bge007/ep4ce6e22-enc28j60-ethernet/docs/OLED-SSD1306-3.jpg

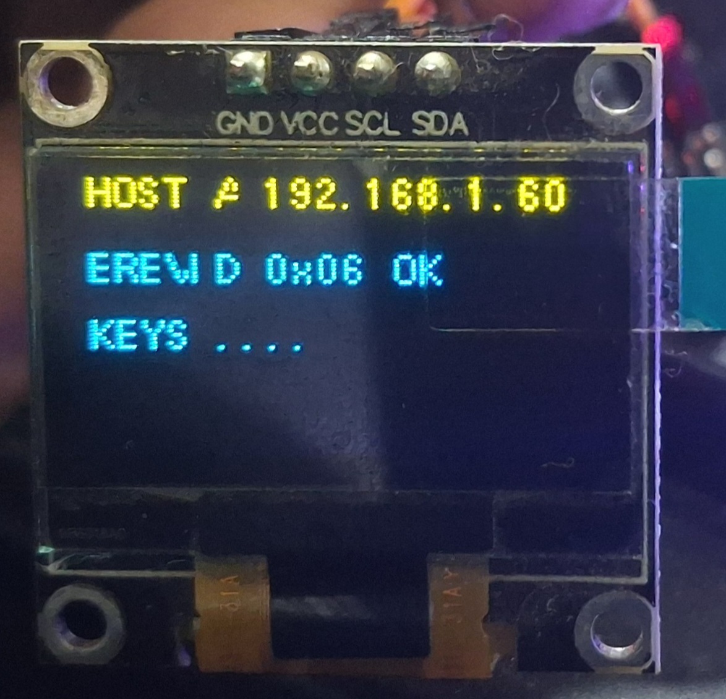
docs/OLED-SSD1306-3.jpg
