bge007/ep4ce6e22-enc28j60-ethernet/rtl/oled_ssd1306.v

// oled_ssd1306.v -- 1.3" 128x64 OLED (QG-2864KSWLG01) over I2C.
//
// Text-only: a 4 x 21 character buffer is rendered to display pages 0, 2, 4
// and 6, leaving the odd pages blank so the lines have air between them.
// Glyphs are 5x8 with a one-column gap, so 21 characters span 126 of 128
// columns.
//
// CONTROLLER IDENTIFICATION
// --------------------------
// The panel's own datasheet is internally inconsistent -- the mechanical
// drawing and section 4.1 both say "SH1106G", but the page-15 reference
// schematic is labelled "SSD1306 / 0.96''". An SH1106 init sequence was
// tried first on that basis and got the panel talking over I2C (clean ACKs)
// but intermittently blank; confirmed on the real module that the silicon is
// actually SSD1306 -- no +2 RAM column offset, and the SSD1306 charge-pump
// command (0x8D 0x14) rather than SH1106's (0xAD 0x8B + VPP 0x32).
//
// Both memories are read synchronously so they infer M9K blocks. Cyclone IV E
// has no LUT RAM, so an asynchronous read would become flip-flops plus a wide
// mux -- around 700 LEs for the character buffer alone. The FSM stalls on the
// I2C master for tens of microseconds per byte, so a cycle of read latency is
// free.

module oled_ssd1306 #(
    parameter integer CLK_HZ    = 50_000_000,
    parameter [6:0]   I2C_ADR   = 7'h3C,           // 0111100b; 0x3D if D/C# high
    // Wait before touching the panel at all. Was 100 ms, raised to 500 ms
    // after a cold-boot failure on real hardware (2026-08-27): on a power-up
    // the panel's own POR runs at the same time as the FPGA's, and at 100 ms
    // it is not yet ready -- it ACKs the init bytes on I2C but ignores them,
    // leaving the display dark. Pressing RESET much later always worked
    // because by then the panel had long since settled. A JTAG reconfigure
    // never showed the fault either, for the same reason.
    parameter integer POR_TICKS    = 25_000_000,   // 500 ms at 50 MHz
    // ...and then do the whole init a second time, once, a second after boot.
    // A fixed delay alone is a tuned guess about someone else's RC circuit;
    // the retry makes a cold boot succeed even if the first attempt was still
    // too early. Harmless when the first attempt already worked -- it just
    // re-initialises and repaints.
    parameter integer REINIT_TICKS = 50_000_000    // 1 s at 50 MHz
) (
    input  wire       clk,
    input  wire       rst,

    // Character buffer write port. addr = line*21 + column.
    input  wire       txt_we,
    input  wire [6:0] txt_addr,
    input  wire [7:0] txt_char,

    input  wire       refresh,                     // pulse: redraw the panel
    output reg        ready,                       // idle and safe to refresh
    output wire       i2c_err,                     // display did not ACK

    inout  wire       oled_scl,
    inout  wire       oled_sda
);

    localparam integer COLS   = 21;
    localparam [7:0]   ADDR_W = {I2C_ADR, 1'b0};   // write address byte, 0x78

    // ------------------------------------------------------------------
    // I2C master
    // ------------------------------------------------------------------
    reg        c_start, c_write, c_stop;
    reg  [7:0] c_data;
    wire       i2c_busy, i2c_ack_err;

    i2c_master #(.CLK_HZ(CLK_HZ), .I2C_HZ(400_000)) u_i2c (
        .clk(clk), .rst(rst),
        .cmd_start(c_start), .cmd_write(c_write), .cmd_stop(c_stop),
        .wr_data(c_data), .busy(i2c_busy), .ack_err(i2c_ack_err),
        .scl(oled_scl), .sda(oled_sda)
    );

    assign i2c_err = i2c_ack_err;

    // ------------------------------------------------------------------
    // Init sequence, standard SSD1306 datasheet order.
    // ------------------------------------------------------------------
    localparam integer INIT_N = 24;
    reg [7:0] initrom [0:INIT_N-1];
    initial begin
        initrom[ 0] = 8'hAE;                        // display off
        initrom[ 1] = 8'h00;                        // lower column = 0
        initrom[ 2] = 8'h10;                        // higher column = 0
        initrom[ 3] = 8'h40;                        // start line 0
        initrom[ 4] = 8'hB0;                        // page 0
        initrom[ 5] = 8'h81; initrom[ 6] = 8'hBF;   // contrast
        initrom[ 7] = 8'hA1;                        // segment remap
        initrom[ 8] = 8'hA6;                        // normal, not inverted
        initrom[ 9] = 8'hA8; initrom[10] = 8'h3F;   // multiplex 1/64
        initrom[11] = 8'h8D; initrom[12] = 8'h14;   // charge pump enable
        initrom[13] = 8'hC8;                        // COM scan remapped
        initrom[14] = 8'hD3; initrom[15] = 8'h00;   // display offset 0
        initrom[16] = 8'hD5; initrom[17] = 8'h80;   // clock divide / osc
        initrom[18] = 8'hD9; initrom[19] = 8'h22;   // pre-charge
        initrom[20] = 8'hDA; initrom[21] = 8'h12;   // COM pins
        initrom[22] = 8'hDB; initrom[23] = 8'h40;   // VCOMH
    end

    localparam [7:0] CTL_CMD  = 8'h00;   // Co=0, D/C=0 -> command stream
    localparam [7:0] CTL_DATA = 8'h40;   // Co=0, D/C=1 -> data stream

    // ------------------------------------------------------------------
    // Column walk. Kept as counters rather than col/6 and col%6, which would
    // otherwise infer constant dividers.
    // ------------------------------------------------------------------
    reg [7:0] col;        // 0..128, where 128 means "page finished"
    reg [2:0] gcol;       // 0..5 within the character cell
    reg [4:0] cidx;       // 0..20 character index in the line
    reg [2:0] page;       // 0..7

    wire       is_text_page = ~page[0];
    wire [1:0] text_line    = page[2:1];

    // ------------------------------------------------------------------
    // Character buffer and font, both synchronous-read (M9K)
    // ------------------------------------------------------------------
    reg [7:0] textbuf [0:COLS*4-1];
    reg [7:0] tb_q;
    wire [6:0] tb_addr = text_line * COLS + cidx;

    // Start blank rather than relying on M9K powering up to zero. Quartus
    // turns this into the RAM's initial contents; without it the unwritten
    // cells read as X in simulation.
    integer k;
    initial for (k = 0; k < COLS*4; k = k + 1) textbuf[k] = 8'h20;   // space

    always @(posedge clk) begin
        if (txt_we) textbuf[txt_addr] <= txt_char;
        tb_q <= textbuf[tb_addr];
    end

    reg [7:0] font [0:474];
    reg [7:0] font_q;
    initial $readmemh("font5x8.mem", font);

    wire        ch_ok   = (tb_q >= 8'd32) && (tb_q <= 8'd126);
    wire [8:0]  ch_off  = ch_ok ? (tb_q - 8'd32) : 9'd0;
    wire [11:0] f_addr  = ch_off * 5 + gcol;

    always @(posedge clk) font_q <= font[f_addr[8:0]];

    // A byte is blank on odd pages, past the end of the line, in the
    // inter-character gap, or for an unprintable code.
    wire blank = !is_text_page || (cidx >= COLS) || (gcol == 3'd5) || !ch_ok;

    // ------------------------------------------------------------------
    // FSM
    // ------------------------------------------------------------------
    localparam S_POR      = 4'd0,
               S_I_START  = 4'd1,
               S_I_ADDR   = 4'd2,
               S_I_CTL    = 4'd3,
               S_I_BYTE   = 4'd4,
               S_I_STOP   = 4'd5,
               S_AFTER_I  = 4'd6,
               S_IDLE     = 4'd7,
               S_P_START  = 4'd8,
               S_P_ADDR   = 4'd9,
               S_P_CTL    = 4'd10,
               S_P_CMD    = 4'd11,
               S_P_DSTART = 4'd12,
               S_P_DADDR  = 4'd13,
               S_P_DCTL   = 4'd14,
               S_P_DATA   = 4'd15;

    reg [3:0]  st;
    reg [26:0] delay;
    reg [4:0]  init_i;
    reg [1:0]  cmd_i;
    reg        turn_on;      // this init pass sends 0xAF rather than the table
    reg        clear_pass;   // paint blanks, not text
    reg        reinit_pending;  // one-shot cold-boot re-init, see REINIT_TICKS
    reg        reinit_repaint;  // after that re-init, repaint text (not just clear)
    reg [26:0] life_cnt;        // cycles since reset, saturating at REINIT_TICKS

    localparam [7:0] LOWER_COL = 8'h00;   // SSD1306: no RAM offset

    wire [7:0] page_cmd = (cmd_i == 2'd0) ? (8'hB0 | {5'd0, page}) :
                          (cmd_i == 2'd1) ? LOWER_COL :
                                            8'h10;      // higher col = 0

    task reset_walk;
        begin
            page  <= 3'd0;
            col   <= 8'd0;
            gcol  <= 3'd0;
            cidx  <= 5'd0;
            cmd_i <= 2'd0;
        end
    endtask

    always @(posedge clk) begin
        c_start <= 1'b0;
        c_write <= 1'b0;
        c_stop  <= 1'b0;

        if (rst) begin
            st         <= S_POR;
            delay      <= 0;
            init_i     <= 5'd0;
            ready      <= 1'b0;
            turn_on    <= 1'b0;
            clear_pass <= 1'b1;
            reinit_pending <= 1'b1;
            reinit_repaint <= 1'b0;
            life_cnt       <= 27'd0;
            reset_walk;
        end else begin
            if (life_cnt != REINIT_TICKS[26:0]) life_cnt <= life_cnt + 27'd1;
            case (st)
                S_POR:
                    if (delay == POR_TICKS) begin
                        delay <= 0;
                        st    <= S_I_START;
                    end else delay <= delay + 1'b1;

                S_I_START:
                    if (!i2c_busy) begin c_start <= 1'b1; st <= S_I_ADDR; end

                S_I_ADDR:
                    if (!i2c_busy && !c_start) begin
                        c_data <= ADDR_W; c_write <= 1'b1; st <= S_I_CTL;
                    end

                S_I_CTL:
                    if (!i2c_busy && !c_write) begin
                        c_data <= CTL_CMD; c_write <= 1'b1; st <= S_I_BYTE;
                    end

                S_I_BYTE:
                    if (!i2c_busy && !c_write) begin
                        if (turn_on) begin
                            c_data  <= 8'hAF;               // display on
                            c_write <= 1'b1;
                            st      <= S_I_STOP;
                        end else if (init_i == INIT_N) begin
                            st <= S_I_STOP;
                        end else begin
                            c_data  <= initrom[init_i];
                            c_write <= 1'b1;
                            init_i  <= init_i + 5'd1;
                        end
                    end

                S_I_STOP:
                    if (!i2c_busy && !c_write) begin c_stop <= 1'b1; st <= S_AFTER_I; end

                // Datasheet order: initialise, clear the RAM, then switch the
                // panel on -- so power-up noise is never displayed.
                S_AFTER_I:
                    if (!i2c_busy && !c_stop) begin
                        if (turn_on) begin
                            // Display-on has just been sent. On the normal
                            // boot path the caller repaints on its next
                            // change, so idling here is fine. After a
                            // re-init it is NOT: the clear pass just blanked
                            // the panel, and eth_top only issues a refresh
                            // when something changes -- so nothing would ever
                            // repaint and the display would sit blank. (That
                            // is exactly what happened on hardware: text for
                            // ~1 s, then the re-init blanked it for good.)
                            // textbuf still holds the text, so paint it back.
                            if (reinit_repaint) begin
                                reinit_repaint <= 1'b0;
                                reset_walk;
                                st <= S_P_START;   // clear_pass is 0 -> paints text
                            end else begin
                                ready <= 1'b1;
                                st    <= S_IDLE;
                            end
                        end else begin
                            reset_walk;
                            st <= S_P_START;
                        end
                    end

                S_IDLE:
                    if (refresh && !i2c_busy) begin
                        ready <= 1'b0;
                        reset_walk;
                        st <= S_P_START;
                    end else if (reinit_pending && !i2c_busy &&
                                 life_cnt == REINIT_TICKS[26:0]) begin
                        // Cold-boot safety net: redo init -> clear -> display-on
                        // once, now that the panel has certainly settled.
                        reinit_pending <= 1'b0;
                        reinit_repaint <= 1'b1;
                        init_i         <= 5'd0;
                        turn_on        <= 1'b0;
                        clear_pass     <= 1'b1;
                        ready          <= 1'b0;
                        reset_walk;
                        st             <= S_I_START;
                    end

                S_P_START:
                    if (!i2c_busy) begin c_start <= 1'b1; st <= S_P_ADDR; end

                S_P_ADDR:
                    if (!i2c_busy && !c_start) begin
                        c_data <= ADDR_W; c_write <= 1'b1; st <= S_P_CTL;
                    end

                S_P_CTL:
                    if (!i2c_busy && !c_write) begin
                        c_data <= CTL_CMD; c_write <= 1'b1; st <= S_P_CMD;
                    end

                S_P_CMD:
                    if (!i2c_busy && !c_write) begin
                        c_data  <= page_cmd;
                        c_write <= 1'b1;
                        if (cmd_i == 2'd2) begin cmd_i <= 2'd0; st <= S_P_DSTART; end
                        else                      cmd_i <= cmd_i + 2'd1;
                    end

                // Repeated START to switch from the command to the data stream.
                S_P_DSTART:
                    if (!i2c_busy && !c_write) begin c_start <= 1'b1; st <= S_P_DADDR; end

                S_P_DADDR:
                    if (!i2c_busy && !c_start) begin
                        c_data <= ADDR_W; c_write <= 1'b1; st <= S_P_DCTL;
                    end

                S_P_DCTL:
                    if (!i2c_busy && !c_write) begin
                        c_data <= CTL_DATA; c_write <= 1'b1; st <= S_P_DATA;
                    end

                S_P_DATA:
                    if (!i2c_busy && !c_write) begin
                        if (col == 8'd128) begin
                            c_stop <= 1'b1;
                            col    <= 8'd0;
                            gcol   <= 3'd0;
                            cidx   <= 5'd0;
                            if (page == 3'd7) begin
                                page <= 3'd0;
                                if (clear_pass) begin
                                    clear_pass <= 1'b0;
                                    turn_on    <= 1'b1;
                                    st         <= S_I_START;   // now send 0xAF
                                end else begin
                                    ready <= 1'b1;
                                    st    <= S_IDLE;
                                end
                            end else begin
                                page <= page + 3'd1;
                                st   <= S_P_START;
                            end
                        end else begin
                            c_data  <= (clear_pass || blank) ? 8'h00 : font_q;
                            c_write <= 1'b1;
                            col     <= col + 8'd1;
                            if (gcol == 3'd5) begin
                                gcol <= 3'd0;
                                cidx <= cidx + 5'd1;
                            end else begin
                                gcol <= gcol + 3'd1;
                            end
                        end
                    end

                default: st <= S_POR;
            endcase
        end
    end

endmodule
