bge007/ep4ce6e22-enc28j60-ethernet/tb/tb_uart.v

// tb_uart.v -- self-checking testbench for the serial console.
//
// What it proves:
//   * uart_tx -> uart_rx round-trips arbitrary bytes at the real bit rate
//   * the banner is transmitted at reset, with the host letter substituted
//   * pressing a button emits "KEYS 0..." with a character per key
//   * a line typed into uart_rx lands in the message buffer and is echoed
//     back as "MSG: ..."
//   * backspace erases, and over-long input is truncated rather than wrapping
//
// Run:  vlog -sv ../rtl/uart_tx.v ../rtl/uart_rx.v ../rtl/uart_console.v ../tb/tb_uart.v
//       vsim -c -do "run -all; quit -f" tb_uart

`timescale 1ns/1ps

module tb_uart;

    localparam integer CLK_HZ = 50_000_000;
    localparam integer BAUD   = 115200;
    localparam real    BIT_NS = 1_000_000_000.0 / BAUD;

    reg clk = 0;
    always #10 clk = ~clk;                 // 50 MHz
    reg rst = 1;

    // ------------------------------------------------------------------
    // Part 1: raw PHY loopback
    // ------------------------------------------------------------------
    reg  [7:0] p_tx_data;
    reg        p_tx_valid;
    wire       p_tx_ready, p_line;
    wire [7:0] p_rx_data;
    wire       p_rx_valid, p_rx_err;

    uart_tx #(.CLK_HZ(CLK_HZ), .BAUD(BAUD)) u_ptx (
        .clk(clk), .rst(rst), .tx_data(p_tx_data), .tx_valid(p_tx_valid),
        .tx_ready(p_tx_ready), .tx(p_line));

    uart_rx #(.CLK_HZ(CLK_HZ), .BAUD(BAUD)) u_prx (
        .clk(clk), .rst(rst), .rx(p_line),
        .rx_data(p_rx_data), .rx_valid(p_rx_valid), .rx_err(p_rx_err));

    reg [7:0] got_byte;
    reg       got_flag;
    always @(posedge clk) if (p_rx_valid) begin got_byte <= p_rx_data; got_flag <= 1'b1; end

    // ------------------------------------------------------------------
    // Part 2: the console
    // ------------------------------------------------------------------
    reg  [3:0] keys = 4'b0000;
    reg        keys_changed = 0;
    reg  [4:0] msg_addr = 0;
    wire [7:0] msg_char;
    wire       msg_updated;
    reg        host_rx = 1'b1;             // idle high, driven by the "PC"
    wire       host_tx;                    // console -> PC

    // Tied off: this testbench covers the UART/console path, not the OLED
    // status lines (tb_oled.v exercises the OLED driver itself). Holding
    // both low keeps req_oled_rdy/req_oled_err from ever firing here, so the
    // existing banner/keys/echo byte-stream assertions below stay exact.
    reg        oled_ready_tb = 1'b0;
    reg        oled_nack_tb  = 1'b0;
    reg        eth_ready_tb  = 1'b0;
    reg  [7:0] eth_econ1_tb  = 8'h00;
    // Both held at zero, matching oled_ready_tb/oled_nack_tb above: never
    // changing keeps req_net from ever firing here too.
    reg [15:0] net_frames_tb  = 16'd0;
    reg [15:0] net_replies_tb = 16'd0;
    reg [7:0]  net_eir_tb     = 8'd0;
    reg [7:0]  net_estat_tb   = 8'd0;
    reg [15:0] net_arpreqs_tb = 16'd0;
    reg [15:0] net_etype_tb   = 16'd0;
    reg [15:0] net_resyncs_tb  = 16'd0;
    reg [15:0] net_tsvcount_tb = 16'd0;
    reg [15:0] net_tsvwire_tb  = 16'd0;
    reg [7:0]  net_tsvs2_tb     = 8'd0;
    reg [7:0]  net_tsvs3_tb     = 8'd0;

    uart_console #(.CLK_HZ(CLK_HZ), .BAUD(BAUD), .HOST_ID(8'd1)) dut (
        .clk(clk), .rst(rst),
        .keys(keys), .keys_changed(keys_changed),
        .msg_rd_addr(msg_addr), .msg_rd_data(msg_char), .msg_updated(msg_updated),
        .oled_ready(oled_ready_tb), .oled_nack(oled_nack_tb),
        .eth_ready(eth_ready_tb), .eth_econ1(eth_econ1_tb),
        .net_frames(net_frames_tb), .net_replies(net_replies_tb),
        .net_eir(net_eir_tb), .net_estat(net_estat_tb),
        .net_arpreqs(net_arpreqs_tb), .net_etype(net_etype_tb),
        .net_resyncs(net_resyncs_tb),
        .net_tsvcount(net_tsvcount_tb), .net_tsvwire(net_tsvwire_tb),
        .net_tsvs2(net_tsvs2_tb), .net_tsvs3(net_tsvs3_tb),
        .uart_rx_pin(host_rx), .uart_tx_pin(host_tx));

    // Collect everything the console transmits.
    wire [7:0] c_rx_data;
    wire       c_rx_valid, c_rx_err;
    uart_rx #(.CLK_HZ(CLK_HZ), .BAUD(BAUD)) u_mon (
        .clk(clk), .rst(rst), .rx(host_tx),
        .rx_data(c_rx_data), .rx_valid(c_rx_valid), .rx_err(c_rx_err));

    reg [7:0] seen [0:255];
    integer   seen_n = 0;
    always @(posedge clk) if (c_rx_valid) begin seen[seen_n] = c_rx_data; seen_n = seen_n + 1; end

    integer errors = 0;
    integer i;

    // A string literal cannot be bit-sliced in place, so park it in a reg.
    reg [8*11-1:0] hello = "Hello World";

    // Drive one byte into the console's RX pin at the real bit rate.
    task pc_send(input [7:0] b);
        integer n;
        begin
            host_rx = 1'b0;                       // start
            #(BIT_NS);
            for (n = 0; n < 8; n = n + 1) begin
                host_rx = b[n];                   // LSB first
                #(BIT_NS);
            end
            host_rx = 1'b1;                       // stop
            #(BIT_NS);
            #(BIT_NS/2);                          // a little idle between bytes
        end
    endtask

    task pc_send_str(input [8*24-1:0] s, input integer len);
        integer n;
        begin
            for (n = len - 1; n >= 0; n = n - 1)
                pc_send(s[8*n +: 8]);
        end
    endtask

    // Does the collected stream contain this string?
    function integer contains(input [8*32-1:0] pat, input integer len);
        integer a, b_, ok;
        begin
            contains = -1;
            for (a = 0; a <= seen_n - len; a = a + 1) begin
                ok = 1;
                for (b_ = 0; b_ < len; b_ = b_ + 1)
                    if (seen[a+b_] !== pat[8*(len-1-b_) +: 8]) ok = 0;
                if (ok && contains < 0) contains = a;
            end
        end
    endfunction

    task check(input cond, input [40*8:0] what);
        begin
            if (!cond) begin $display("FAIL: %0s", what); errors = errors + 1; end
        end
    endtask

    initial begin
        got_flag = 0;
        #200 rst = 0;

        // ---------------- PHY loopback ----------------
        @(posedge clk);
        wait (p_tx_ready);
        p_tx_data = 8'hA5; p_tx_valid = 1; @(posedge clk); p_tx_valid = 0;
        wait (got_flag);
        check(got_byte === 8'hA5, "loopback byte 0xA5 corrupted");
        check(p_rx_err === 1'b0,  "loopback framing error");
        got_flag = 0;

        wait (p_tx_ready);
        p_tx_data = 8'h3C; p_tx_valid = 1; @(posedge clk); p_tx_valid = 0;
        wait (got_flag);
        check(got_byte === 8'h3C, "loopback byte 0x3C corrupted");
        $display("INFO: PHY loopback OK");

        // ---------------- banner ----------------
        #(BIT_NS * 12 * 26);
        check(contains("EP4CE6E22 node A ready", 22) >= 0,
              "banner not transmitted, or host letter wrong");
        $display("INFO: banner seen, %0d bytes so far", seen_n);

        // ---------------- identity line ----------------
        // Emitted once at power-up and then every ~2.7 s, so a build tool can
        // work out which board is on the other end of a console cable by
        // listening alone -- no reset (which would throw away the run's state)
        // and no keystroke (which would collide with the typed-message path).
        // The ID line is 52 characters now that it carries the MAC readback;
        // this window has to clear the whole line or the checks that follow
        // start reading mid-sentence.
        #(BIT_NS * 12 * 56);
        check(contains("ID HOST=A BLD=", 14) >= 0,
              "identity line missing or malformed");
        $display("INFO: ID line seen");
        seen_n = 0;

        // ---------------- button press ----------------
        seen_n = 0;
        @(posedge clk); keys = 4'b0001; keys_changed = 1; @(posedge clk); keys_changed = 0;
        #(BIT_NS * 12 * 13);
        check(contains("KEYS 0...", 9) >= 0, "KEYS line wrong for key0 pressed");

        seen_n = 0;
        @(posedge clk); keys = 4'b1010; keys_changed = 1; @(posedge clk); keys_changed = 0;
        #(BIT_NS * 12 * 13);
        check(contains("KEYS .1.3", 9) >= 0, "KEYS line wrong for keys 1 and 3 pressed");
        $display("INFO: button lines OK");

        // ---------------- receive a line ----------------
        seen_n = 0;
        pc_send_str(hello, 11);
        pc_send(8'h0D);                            // CR terminates
        #(BIT_NS * 12 * 32);

        check(msg_updated === 1'b0, "msg_updated should be a 1-cycle pulse, not level");
        for (i = 0; i < 11; i = i + 1) begin
            msg_addr = i[4:0];
            @(posedge clk); @(posedge clk);
            if (msg_char !== hello[8*(10-i) +: 8]) begin
                $display("FAIL: msg[%0d] = 0x%02h ('%0s'), expected '%0s'",
                         i, msg_char, msg_char, hello[8*(10-i) +: 8]);
                errors = errors + 1;
            end
        end
        // the tail must be blank, not leftovers
        msg_addr = 5'd15; @(posedge clk); @(posedge clk);
        check(msg_char === 8'h20, "message tail not blank-padded");
        check(contains("MSG: Hello World", 16) >= 0, "line not echoed back as MSG:");
        $display("INFO: line receive + echo OK");

        // ---------------- backspace ----------------
        seen_n = 0;
        pc_send_str("abX", 3);
        pc_send(8'h08);                            // backspace kills the X
        pc_send(8'h0A);                            // LF also terminates
        #(BIT_NS * 12 * 32);
        msg_addr = 5'd0; @(posedge clk); @(posedge clk);
        check(msg_char === "a", "backspace test: msg[0] wrong");
        msg_addr = 5'd1; @(posedge clk); @(posedge clk);
        check(msg_char === "b", "backspace test: msg[1] wrong");
        msg_addr = 5'd2; @(posedge clk); @(posedge clk);
        check(msg_char === 8'h20, "backspace did not erase the character");
        $display("INFO: backspace OK");

        if (errors == 0)
            $display("PASS: UART loopback, banner, ID line, key lines, line receive, echo, backspace");
        else
            $display("%0d ERROR(S)", errors);
        $finish;
    end

    initial begin
        #500_000_000;
        $display("FAIL: timeout");
        $finish;
    end

endmodule
