bge007/ep4ce6e22-enc28j60-ethernet/(commit log)

2026-08-22 M1: SPI master and ENC28J60 EREVID readback
    First milestone of a hardware ARP/ICMP/UDP stack for the EP4CE6E22 driving
    an ENC28J60 over SPI. Proves the full SPI path end to end: reset sequencing,
    soft reset opcode, bank select, and an EREVID read displayed on the LEDs.
    - spi_master.v: byte-streaming SPI mode 0, burst-capable, parameterised divider
    - eth_top.v: reset/init FSM, EREVID read at 12.5 MHz, LED display with a
    button-held alternate view for diagnosing stuck MISO
    - tb_m1.v: self-checking testbench against a behavioral ENC28J60 slave model
    - docs: design rationale and throughput budget, two-node wiring including the
    crossover requirement, and LED-by-LED bring-up guidance
    Simulat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
    [eth_top.v, spi_master.v, tb_m1.v]
2026-08-22 Move the SPI bus onto the fixed-3.3V header (bank 6)
    Board photographs resolved the header layout that was previously guessed, and
    the old assignment turned out to be unsafe.
    PIN_110/111 sit on the top header, the C group, whose bank voltage is chosen
    with a jumper cap and which the fitter reports as bank 7. The ENC28J60 drives
    SO and INT at 3.3 V, so an FPGA input there with VC jumpered to 1.2 or 2.5 V
    is over-driven. All six signals now sit on the right-hand header, which the
    board documents as a fixed 3.3 V group and which is bank 6 throughout:
    enc_sck 105 enc_cs_n 104
    enc_mosi 106 enc_rst_n 100
    enc_miso 103 enc_int 98
    PIN_101 is skipped rather than used for INT. It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
2026-08-22 Add bill of materials
    Splits into per-node items (buy two), shared items (buy one), a contingency
    group for the rail-sag case, and the free software list. Rough marketplace
    prices give a sense of scale: about $50-90 for a complete two-node build.
    Documents four purchasing traps that are easy to get wrong and annoying to
    discover after delivery:
    - the Ethernet cable must be a crossover, with a 10/100 switch plus two patch
    cables as the easier-to-buy substitute (at the cost of forced full duplex)
    - female-to-female jumpers, since both headers present male pins and
    male-to-female ribbons are the more common purchase
    - short jumpers, because Quartus rejects slew-rate and drive-strength con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
2026-08-22 Add board reference photos to the wiring docs
    The three vendor images that settled the pinout: the ENC28J60 module's 2x5
    header order, the EP4CE6E22 header layout, and the vendor's annotated diagram
    stating that the right-hand pins are a fixed 3.3 V group while the C and B
    groups need a jumper cap. Embedding them makes docs/wiring.md checkable
    against the physical boards instead of asking the reader to trust a table.
    The annotated diagram also carries the JTAG header pinout, which is useful
    when wiring a USB-Blaster, so that is called out in the text.
    These are vendor product and manual images, not original work of this
    project. Both the README licence section and a new "Image credits" sec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
2026-08-22 Add the jumper wiring diagram to the docs as a standalone SVG
    Puts the diagram where the wiring instructions are, so the docs no longer
    depend on an external link to show what connects to what. Rendered at the top
    of docs/wiring.md and in the README's wiring section.
    Three things were needed to make an SVG authored for inline HTML work as a
    standalone file that GitHub will render:
    - CSS custom properties and currentColor were baked into literal colours,
    since neither resolves once the file is detached from the page that
    defined them, and an explicit ground rect was added so the figure stays
    legible against both the light and dark GitHub themes
    - source comments were stripped: they us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
2026-08-22 Add 1.3" SH1106 OLED over I2C to both nodes
    Each node gets a 128x64 panel so the message crossing the link is visible
    without a PC attached. New RTL: a write-only open-drain I2C master at 400 kHz,
    an SH1106 driver with a 4 x 21 character buffer rendered to pages 0/2/4/6, and
    a generated ASCII font.
    Two findings from the panel datasheet drove the design.
    The controller is an SH1106, not an SSD1306. The SH1106 carries 132 columns of
    display RAM with the 128-pixel panel centred in it, so panel column 0 is RAM
    column 2 and every page must address column 0x02 rather than 0x00. The vendor's
    own init listing does this. Without it the image sits two pixels right with the
    rightmost columns wrapped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
2026-08-22 Add the OLED to the wiring diagram and the BOM
    The diagram now shows all three boards per node. Each node gains a 1.3" OLED
    box with its four pins and a mock-up of the status text it displays, wired back
    to the same fixed-3.3 V right-hand header: SCL on 85 and SDA on 86, with VCC
    and GND branching off the rails the ENC28J60 already uses. Those two shared
    rails are drawn dashed so it is clear they are branches rather than separate
    pins. Jumper count per node goes from eight to twelve, twenty-four for the
    build.
    The canvas grew from 1080x1140 to 1080x1180 and the second node moved down
    accordingly; the crossover cable now runs between the RJ45s at their new
    positions. Regenerated docs/wiring-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
2026-08-23 Add UART console, button input, and a PowerShell terminal
    Each node now exposes a 115200 8N1 console on the onboard CH340, so one USB-C
    cable carries power and the terminal with no dongle. The console prints a
    banner at reset, prints a line whenever a button changes, and takes a line you
    type and puts it on the OLED's bottom row -- the manual version of the
    milestone-4 demo, running locally until the Ethernet stack exists.
    UART pins are PIN_10 (TX) and PIN_23 (RX), silkscreened TX_10 and RX 23 beside
    the CH340. They are dedicated to it rather than brought out on the B or C group
    headers, so no jumper cap affects them and nothing needs wiring. Same
    assignment hello_demo used, which was verif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
    [debounce.v, eth_top.v, tb_uart.v, uart_console.v, uart_rx.v, uart_tx.v]
2026-08-23 Switch the two-node link from a crossover cable to a 10/100 switch
    A crossover cable is not readily available, and a switch is the easier,
    cheaper thing to source right now, so this project is now built and
    documented against a switch plus two ordinary straight-through patch cables
    as the primary path -- a direct crossover cable is documented as a valid
    alternative but no longer the assumed one.
    The underlying constraint is unchanged: the ENC28J60 has no Auto-MDIX and no
    manual MDI/MDI-X swap in its PHY registers, so the crossing has to happen
    somewhere between the two RJ45 jacks. A switch does it internally; a
    straight-through cable direct between two boards does not, and wires
    transmitter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
2026-08-23 Fix -Prog: this loader needs .rbf, not .sof
    First real hardware attempt on Host A failed programming with
    "Error: Failed to claim FPGA device: Error: wrong file" -- not a driver
    problem, despite the old error message pointing at Zadig. This clone
    USB-Blaster + openFPGALoader combination rejects a raw .sof and needs the
    converted raw bitstream (.rbf) instead, matching what was already found and
    documented for this exact cable during JTAG bring-up.
    -Prog now runs quartus_cpf to produce the .rbf before invoking the loader.
    Verified on hardware: JTAG detects idcode 0x020f10dd (EP4CE6) both before and
    after programming, and the UART console round-trips real bytes afterward --
    sending "Hello Worl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
2026-08-23 M2: link/MAC init -- RX/TX buffer, MAC config, MAC address, RXEN
    Configures the ENC28J60 for reception: RX buffer 0x0000-0x19FF with the
    ERXRDPT-odd-address errata satisfied for free (0x19FF is odd), TX from
    0x1A00, a unicast+broadcast+CRC-valid receive filter (no pattern match, per
    errata), MAC config for half duplex (this project runs through a switch, see
    plan.md#duplex), a locally-administered MAC address 02:42:CE:60:00:<HOST_ID>
    in the ENC28J60's documented reversed MAADR file order, and finally RXEN.
    Implemented as a ROM-driven SPI sequencer: a flat list of {opcode, data}
    transactions, write-or-read decoded structurally from the opcode's own top
    bits, extending the existing M1 FSM rat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
    [eth_top.v, tb_m2.v, tb_uart.v, uart_console.v]
2026-08-23 Add M3: ARP responder (net_stack.v), hardware-verified on Host A
    Implements the RX/TX engine over the ENC28J60's SPI+buffer interface and a
    byte-correct ARP reply generator (mirror-and-patch: swap MACs, set OPER=2,
    set SHA/SPA to ours, mirror THA/TPA from the request's SHA/SPA). eth_top now
    hands the SPI bus to net_stack via a level mux once M2 completes, with a new
    S_HANDOFF terminal state so the old M1/M2 FSM stops reacting to spi_done
    once net_stack owns the bus.
    Bugs found and fixed along the way:
    - net_stack left ECON1 on bank 0 after freeing RX buffer space, so every
    EPKTCNT poll after the first frame silently read the wrong bank and never
    saw a new packet. Fixed by routing S_CLEA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
    [eth_top.v, net_stack.v, oled_sh1106.v, tb_m1.v, tb_m2.v, tb_m3.v]
2026-08-23 build.ps1: add -ProgOnly to program without recompiling
    Programs the board from the existing output_files\enc28j60_eth.sof and
    exits, skipping both the Questa simulation and the Quartus compile --
    useful for reflashing the same bitstream to a different board or after a
    power cycle, without waiting on a full rebuild.
2026-08-23 docs: correct stale SH1106/hardware-status claims, document OLED reset gotcha
    The OLED panel is confirmed SH1106G (not SSD1306 -- the vendor datasheet's
    own page-15 schematic mislabels it, addressed already in docs/oled.md), but
    several docs still said "not tested on hardware" for milestones that are now
    hardware-confirmed (M1 EREVID/LEDs, the OLED panel, the UART console, M2's
    RXEN, M3's ARP responder flashed to Host A). Updated README.md, docs/plan.md
    and docs/serial-console.md to match.
    Also documents a real recurring symptom: the OLED panel goes blank after a
    fresh reflash despite clean I2C ACKs. This isn't an SSD1306/SH1106 command
    mismatch (that hypothesis was tried via the OLED_SSD13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
2026-08-23 Correct OLED controller: SSD1306, not SH1106 -- confirmed on real hardware
    The panel's own datasheet is self-contradictory (mechanical drawing and
    section 4.1 say SH1106G, the page-15 reference schematic says SSD1306), and
    this project initially trusted the mechanical-drawing label. Confirmed
    directly on the physical module that the real silicon is SSD1306, not
    SH1106.
    Renames rtl/oled_sh1106.v -> rtl/oled_ssd1306.v and drops the SH1106 code
    path entirely rather than keeping it behind a parameter -- the earlier
    OLED_SSD1306_COMPAT escape hatch (added when this was still an open
    question) is no longer needed now that the controller is confirmed, so
    eth_top.v no longer takes that parameter ei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
    [eth_top.v, i2c_master.v, oled_ssd1306.v, tb_oled.v]
2026-08-23 docs: swap OLED reference photo for the correct SSD1306 module
    The old 1.3inch-oled-pin.jpg was a different vendor's blue-PCB 1.3" module
    pinout diagram, not a photo of the SSD1306 unit actually used in this
    project -- keeping it around after the SH1106->SSD1306 correction would have
    been a lingering source of confusion. Replaced with OLED-SSD1306-1.jpg
    (back, showing the 0x78/0x7A address-select markings) and
    OLED-SSD1306-2.jpg (front, showing the GND/VDD/SCK/SDA header) in
    docs/oled.md's Module pinout section, updated docs/wiring.md's image-credit
    list to match, and deleted the old file.
2026-08-23 build.ps1: add -Flash/-FlashOnly for non-volatile config-flash programming
    -Prog/-ProgOnly only ever wrote the FPGA's SRAM, which is lost on every
    reset or power-cycle -- exactly the "volatile" behavior the user hit after
    a board reset. Cyclone IV's Active Serial config flash is reachable over the
    same JTAG link via openFPGALoader's spiOverJtag bridge mechanism (-f), which
    loads a small bitstream into SRAM that turns the JTAG link into a passthrough
    to the board's actual config flash chip.
    Confirmed on hardware: the board's flash is a Winbond-compatible chip (JEDEC
    EF 30 13, 512 KB) reached via `--fpga-part ep4ce622`, with the matching
    prebuilt bridge already present at C:\FPGA\tools\share\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
2026-08-23 uart_console: add "NET F=xxxx R=xxxx" line for M3 hardware diagnosis
    ping 192.168.1.60 still reports "Destination host unreachable" (ARP never
    resolving) even after M3 (net_stack, the ARP responder) was flashed and
    passed simulation. net_stack's own frames_seen/arp_replies_sent counters
    existed already but were never surfaced anywhere observable on real
    hardware -- eth_top just left them as dangling wires.
    Adding them to the serial console (fires whenever either counter changes)
    turns "ping doesn't work" into a diagnosable signal instead of a guess:
    - F stuck at 0: the ENC28J60 never saw a frame at all -- link/physical
    layer problem, or the MAC filter is rejecting everything.
    - F in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
    [eth_top.v, tb_uart.v, uart_console.v]
2026-08-23 net_stack: try full duplex, add EIR/ESTAT TX-status readback diagnostic
    Continuing the M3 hardware-vs-simulation gap: ping still reports
    "Destination host unreachable" even though net_stack's own frames_seen/
    arp_replies_sent counters show ARP requests arriving and replies being
    generated. pktmon on the PC (both over Wi-Fi and, after ruling out AP
    isolation by testing over a direct wired connection to the same switch)
    shows literally zero frames from the FPGA's MAC ever arriving -- not
    malformed, absent -- which points at the frame being dropped before/at the
    switch, most plausibly a bad or missing FCS that a switch silently discards.
    Two changes:
    - MACON3.FULDPX set (0x33, was 0x32) with M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
    [eth_top.v, net_stack.v, tb_m2.v, tb_m3.v, tb_uart.v, uart_console.v]
2026-08-23 Add Host B as a second Quartus revision, wire it into build.ps1 -HostB
    Same RTL source tree, not a second project -- matching plan.md's original
    intent ("build one source twice via a HOST_ID parameter, not two projects").
    enc28j60_eth_hostb.qsf is a copy of enc28j60_eth.qsf with two differences:
    its own PROJECT_OUTPUT_DIRECTORY (output_files_hostb, so building one host
    never overwrites the other's .sof/.rbf) and `set_parameter -name HOST_ID 2`,
    which eth_top.v already used to derive 192.168.1.61 and MAC ...:02 -- that
    parameterization existed since M1 but nothing ever actually built it.
    build.ps1 gets a new -HostB switch, composable with all the existing ones
    (-Prog, -Flash, -ProgOnly, -Fla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
2026-08-23 net_stack: reset transmit logic (ECON1.TXRST) before every TX attempt
    Real hardware evidence, 2026-08-24: with the new EIR/ESTAT readback added
    last commit, every single ARP-reply attempt read back EIR=0x40 (PKTIF set,
    but TXIF -- "last transmission completed" -- never set, across dozens of
    attempts) and ESTAT=0x01 (only CLKRDY; no TXERIF/TXABRT/LATECOL error flags
    either). No completion and no error is the signature of the ENC28J60's
    documented transmit-logic errata: the TX logic can get stuck after use and
    must be explicitly reset (ECON1.TXRST pulsed high then low) before every
    subsequent transmission, not just the first. net_stack never did this --
    straight to asserting TXRTS every time.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
    [net_stack.v]
2026-08-23 net_stack: pad ARP reply to Ethernet's 60-byte minimum explicitly
    Continuing the M3 hardware debug: with the TXRST errata fix, EIR now
    confirms TXIF (transmission complete) with no error flags -- but ping still
    failed and a fresh pktmon capture on the PC still showed zero frames from
    the FPGA's MAC arriving anywhere, wired or Wi-Fi.
    The ARP reply itself is only 42 bytes (56 with the dest/src/EtherType
    header), well under Ethernet's 60-byte minimum frame size. Padding this up
    was left to MACON3's PADCFG bits, but that write was never independently
    verifiable -- the abandoned MAC-register readback (see eth_top.v's cfg_op
    comment) -- and TXIF completing cleanly doesn't prove the frame was actu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
    [net_stack.v, tb_m3.v]
2026-08-23 Add M4: UDP message send/receive between Host A and Host B
    The project's "Hello World" demo: a fixed-format UDP datagram to port 1234
    whose payload is exactly uart_console's 21-byte message buffer (the same
    text shown on the OLED). A line typed on either board's serial console
    is sent to the peer and shown on its OLED line 3; whichever of "typed
    locally" or "received from peer" happened more recently wins that line.
    Design choices that keep this simple rather than building a general UDP/IP
    stack:
    - No ARP client. Only two hosts ever exist, so the peer's MAC/IP are
    derived from HOST_ID with the same formula eth_top.v already uses for
    OUR_MAC/OUR_IP (net_stack gets a new HOST_ID parameter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
    [eth_top.v, net_stack.v, tb_m4.v, uart_console.v]
2026-08-26 net_stack: pulse TXRST *before* loading EWRPT/ETXND, not after
    A Cisco L2 switch with both boards attached settles the question the PC-side
    captures could not: `show mac address-table` never learns 0242.ce60.0001 or
    0242.ce60.0002 on any port. A switch learns a source MAC from any valid frame
    it receives, so zero entries means not one valid frame has ever reached the
    wire from either board -- independent of IP, ARP, or anything above layer 2,
    and identical on both boards.
    That is consistent with the TXRST pulse being sequenced wrong. Resetting the
    ENC28J60's transmit logic also resets its transmit pointer registers, and the
    previous ordering was:
    bank0 -> EWRPT -> write frame -> ETXND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
    [net_stack.v]
2026-08-26 Revert MAC to half duplex to match the link the switch actually negotiates
    MACON3 0x33 -> 0x32 (FULDPX=0) and MABBIPG 0x15 -> 0x12.
    These were set to full duplex on 2026-08-23 while testing a duplex-mismatch
    theory, and wrongly left that way when it did not immediately fix anything --
    leaving the design in a state that is actively wrong for this network.
    Direct evidence from the Cisco 2960 the boards are attached to:
    Gi1/0/13 connected 1 a-half a-10
    GigabitEthernet1/0/13 is up, line protocol is up (connected)
    Half-duplex, 10Mb/s, media type is 10/100/1000BaseTX
    0 packets input, 8957 bytes, 0 no buffer
    0 runts, 1 giants, 0 throttles
    1 input erro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
    [eth_top.v, tb_m2.v]
2026-08-26 net_stack: re-arm ETXST after every TXRST pulse
    ETXST was written once during M2 init and never again, assuming it stays
    put. TXRST resets the transmit logic, which plausibly includes the transmit
    start pointer -- and if it does, the part transmits from wherever ETXST
    landed (0x0000, the RX buffer) through ETXND=0x1A3C, about 6.7 KB. That is
    exactly the oversized frame the switch had counted as "1 giants".
    Writes ETXST explicitly right after the TXRST pulse on both TX paths,
    removing the assumption.
    Measured on hardware via the Cisco 2960 (SSH, key auth), counters cleared
    first so the reading is attributable to this bitstream:
    Last input never
    0 packets input, 0 bytes
    0 runts,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
    [net_stack.v]
2026-08-26 MACON4 DEFER (datasheet-confirmed) + RX-parsing telemetry; fault relocated to RX
    Fetched the actual ENC28J60 datasheet (DS39662E) at last, which replaces
    guesswork with citable fact and immediately found a real defect.
    MACON4 0x00 -> 0x40 (DEFER). Datasheet section 6.5 step 3: "Configure the
    bits in MACON4. For conformance to the IEEE 802.3 standard, set the DEFER
    bit." With DEFER clear in half duplex the part will "abort the transmission
    after the excessive deferral limit is reached" whenever the medium is
    occupied -- which on a busy segment is most of the time.
    That matched the Cisco 2960 counters exactly: InOctets 1140 with
    InUcastPkts/InMcastPkts/InBcastPkts all zero AND Align-Err, FCS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
    [eth_top.v, net_stack.v, tb_m2.v, tb_m3.v, tb_m4.v, tb_uart.v, uart_console.v]
2026-08-26 Add a real power-on reset; add PHCON2.HDLDIS via MIIM
    POWER-ON RESET (fixes "OLED only appears after pressing RESET")
    The design had no POR at all. Cyclone IV registers come out of configuration
    cleared, so rst_sync powered up to 2'b00 and `rst` was never asserted -- every
    reset block was skipped, and every register whose reset value is not zero
    started life wrong:
    oled_ssd1306.clear_pass 1 -> 0 display-on 0xAF never sent, panel dark
    uart_console.req_banner 1 -> 0 no boot banner
    eth_top.m12_cs_n 1 -> 0 ENC28J60 chip-select ASSERTED from
    net_stack.cs_n 1 -> 0 configuration -- the first SPI transaction
    had no framing CS edge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
    [eth_top.v, tb_m2.v]
2026-08-26 oled: longer cold-boot settle time plus a one-shot re-init
    The power-on reset added earlier was a real fix (the boot banner now appears
    without a button press) but it was NOT what kept the OLED dark after a cold
    power cycle. Confirmed on hardware 2026-08-27: with the POR in the config
    flash, a power cycle still came up blank and still needed a RESET press.
    The remaining cause is the panel's own power-on reset. On a cold boot the
    module powers up at the same time as the FPGA, and the driver began sending
    I2C init after only ~100 ms. The panel ACKs those bytes but ignores them, so
    the display stays dark -- which is why clean I2C ACKs never flagged it, and
    why pressing RESET much later always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
    [oled_ssd1306.v]
2026-08-26 oled: repaint text after the cold-boot re-init (fixes blank-after-1s regression)
    Regression introduced by the previous commit. On hardware the panel showed
    text for about a second and then went blank -- after flashing, after a RESET
    press, and after a power cycle alike.
    Cause: the re-init runs init -> clear -> display-on and then drops to idle.
    The clear pass blanks the panel, and eth_top's display writer only issues a
    refresh when something *changes* (EREVID, a button, a message). After a
    re-init nothing has changed, so no repaint was ever triggered and the panel
    stayed blank. The ~1 s delay before going dark is exactly REINIT_TICKS.
    Fix: track the re-init through to completion with reini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
    [oled_ssd1306.v]
2026-08-26 docs/oled.md: replace the stale "press RESET" note with the real fix
    The troubleshooting section told readers to press the RESET button, which was
    the workaround, not the cause -- and is now wrong, since the board comes up on
    its own. Rewritten to record what the fault actually was: two independent
    faults stacked, a missing FPGA power-on reset (so display-on 0xAF was never
    sent) and the panel's own POR being slower than our first I2C write (it ACKs
    the init bytes and ignores them at ~100 ms).
    Also documents why the retry has to end in a repaint, and adds a short
    "if a blank panel ever comes back" checklist that puts the cheap checks first
    -- notably that a power cycle boots from config flas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
2026-08-26 Accept broadcast UDP so a PC can drive the OLED without the TX path
    Route around the transmit fault instead of waiting on it. Receive is
    confirmed good on hardware -- the ENC28J60 activity LED blinks on traffic,
    frames_seen climbs, EtherTypes decode correctly -- while transmit is still
    unexplained. A broadcast message needs nothing from the board's transmit
    side, so the display becomes usable today.
    net_stack now accepts a UDP datagram whose destination IP is OUR_IP, the
    limited broadcast 255.255.255.255, or the subnet broadcast (OUR_IP with the
    host byte 0xFF, i.e. 192.168.1.255). Previously anything not addressed
    exactly to OUR_IP was dropped. Broadcast frames already passed the MAC
    filte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
    [net_stack.v, tb_m4.v]
2026-08-26 Force per-packet CRC (control byte 0x07) -- ARP now works on hardware
    ROOT CAUSE FOUND, and it took reading the chip's own transmit status vector
    rather than inferring from switch counters.
    Added a TSV readback: after every transmission the ENC28J60 writes a 7-byte
    status vector just past ETXND (datasheet 7.1 / Table 7-1). It is readable
    over RBM -- the buffer-read path already proven working -- so it needs none
    of the MAC-type register read protocol this project could never get right.
    Surfaced on the console as "TSV n=.. w=.. s2=.. s3=..".
    Hardware said:
    TSV n=003C w=003C s2=90 s3=00
    60 bytes queued, 60 bytes actually transmitted on the wire, Transmit Done
    set, zero collisions, zero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
    [eth_top.v, net_stack.v, tb_m3.v, tb_m4.v, tb_uart.v, uart_console.v]
2026-08-26 net_stack: recover from a corrupted RX pointer chain instead of chasing it
    The per-packet "next packet pointer" is the only thing keeping the receive
    side aligned -- each packet is read from wherever the previous one said the
    next begins. One bad value desyncs the chain permanently: from then on the
    "header" is really packet payload, every EtherType is nonsense, and nothing
    is ever recognised again.
    Observed on hardware 2026-08-27, and it explains a failure mode that looked
    like several different bugs. Host B ran correctly for a while (ARP resolved,
    switch learned 0242.ce60.0002 on Gi1/0/17, ping reached "Request timed out"),
    then degraded: frames_seen kept racing while arp_reqs froze at 0x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
    [eth_top.v, net_stack.v, tb_m3.v, tb_m4.v, tb_uart.v, uart_console.v]
2026-08-26 Revert the RXEN-preserving bank selects: hardware says they made it worse
    Tried keeping RXEN set through the bank-0 selects in the RX path (0x00 ->
    0x04), on the reasoning that a plain WCR overwrites all of ECON1 and so every
    "select bank 0" was switching the receiver off as a side effect, leaving it
    off for most of each packet's processing.
    Hardware disagreed, clearly. A freshly reset Host B went from
    A=0003 R=0001 X=0000 (working, answering ARP) to A=0000 with rx_resyncs
    climbing roughly once every two frames and not one ARP request recognised.
    Reverted, and the comment now records the result so this does not get
    "fixed" again without evidence.
    Post-revert measurement, both nodes: correc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
    [net_stack.v]
2026-08-26 net_stack: RXRST-based hard resync -- nodes now self-recover, but not reliably
    Replaces the previous "resync" (which only moved our own next_rdpt to ERXST)
    with a real receive-logic reset, since the hardware's write pointer is
    wherever it is and assuming the next packet sits at ERXST just re-reads stale
    bytes forever -- the observed loop, with rx_resyncs climbing while last_etype
    alternated 0600/0303 endlessly.
    On a provably corrupt next-packet pointer the design now: pulses
    ECON1.RXRST with RXEN held clear (also the condition the datasheet requires
    before ERXST/ERXND may be modified), rewrites ERXST/ERXND, puts ERXRDPT back
    to ERXND (0x19FF, odd, satisfying the errata), and returns via S_I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
    [net_stack.v]
2026-08-26 Add pc/watch-both.ps1; record what the silicon errata does and does not explain
    Fetched the ENC28J60 Rev B7 silicon errata (DS80349C, saved alongside the
    datasheet as enc28j60-errata.pdf/.txt). It validates the workarounds already
    in the design and rules out several standing theories, but does not name the
    drift failure:
    * Item 14, even ERXRDPT values corrupt the receive buffer: net_stack's
    formula matches the errata's Example 2 exactly, wrap case included. Not
    our bug -- this had been the top suspect for a long time.
    * Item 5, writing ERXST/ERXND may store 0000h in the internal receive Write
    Pointer instead of ERXST: benign here, because the prescribed workaround
    IS to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
2026-08-27 Fix ECON1 bank selects silently clearing RXEN
    ECON1 holds the bank-select bits in the same byte as RXEN (bit 2) and
    TXRTS (bit 3), so the whole-byte "wcr_data <= 8'h00" used to select bank 0
    also switched the receiver off. Four sites did this, on the receive
    cleanup, transmit and message paths. Both nodes would answer ARP for
    anywhere from thirty seconds to a few minutes and then stop receiving
    entirely, counters frozen.
    An earlier attempt to write 0x04 instead (bank 0 with RXEN preserved) made
    things worse for the same underlying reason from the other side: it clears
    TXRTS, aborting any frame in flight. No whole-byte value for ECON1 is safe.
    Move every ECON1 access to the BFS/BFC bit-fiel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
    [net_stack.v, tb_m3.v, tb_m4.v]
2026-08-27 Fix two-byte SPI helpers hanging when data equals the opcode
    The WCR, RCR, BFS/BFC and EPKTCNT-poll helpers each worked out whether they
    had already sent their opcode by comparing the byte just shifted out against
    the opcode itself. That holds until the data byte equals the opcode byte, at
    which point the comparison stays true, the helper resends the data, matches
    again, and the FSM spins forever with the packet still pending.
    WCR(ERDPTL) is 0x40 and WCR(ERXRDPTL) is 0x4C, and both are written with the
    low byte of an RX ring pointer, which walks all 256 values as packets advance
    up the buffer. Two chances in 256 per frame, so a mean of ~128 frames to
    failure. Observed wedges on hardware: 12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
    [eth_top.v, net_stack.v, tb_m3.v, uart_console.v]
2026-08-27 Implement the errata-19 reset sequence for a part in an unknown state
    Reflashing the FPGA over JTAG restarts the FPGA but leaves the ENC28J60 exactly
    as it was: mid-stream, buffer full, pointers wherever they happened to be. The
    driver resets to "empty buffer, start at ERXST", the two disagree, and every
    frame afterwards parses as garbage. Nodes came up with frames counted but not
    one recognised as ARP, nothing ever transmitted, and the resync counter in the
    hundreds:
    F=014D R=0000 E=00 S=00 A=0000 T=0000 X=0095
    The driver did issue a System Reset (0xFF) at startup, which is why this looked
    like it should already be handled. Errata DS80349C item 19: a part in Power
    Save mode ignores th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
    [eth_top.v, tb_m1.v, tb_m2.v]
2026-08-27 Show a build identifier on the OLED
    Line 2 now reads "KEYS .... BLD xxxx", from a BUILD_ID localparam at the top of
    eth_top.v. Bump it whenever you flash a build you need to tell apart from
    another one.
    Knowing at a glance which image is on which board is worth more than it sounds:
    several wrong conclusions during bring-up came from testing a node that was
    quietly running an older bitstream, and the two boards routinely sit one flash
    apart because there is a single USB-Blaster between them.
    [eth_top.v]
2026-08-28 Record M3 stability results and the plan for the remaining fault
    M3's functional exit criterion is met -- the ARP responder answers on real
    hardware, ping moves from "unreachable" to "timed out", the switch learns both
    MACs. The sustained half is not: a node runs correctly for a few minutes and
    then stops receiving.
    Document the four hardware-only faults found and fixed so far (TX CRC, ECON1
    bank selects clearing RXEN, the SPI helper phase hang, and reflashing not
    resetting the ENC28J60), with the measured runs behind each, and state plainly
    that the one remaining fault is the RXRST resync failing to restore reception:
    X climbs into the hundreds, the part stops delivering, the FSM stays ali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
2026-08-28 Recover from a corrupt RX chain by re-running the full bring-up
    The RXRST-based resync never worked. Pulsing ECON1.RXRST resets the receive
    logic but leaves the part's write pointer somewhere the driver cannot know, so
    assuming the next packet sits at ERXST re-read stale bytes and the chain was
    corrupt again immediately. On hardware that showed as rx_resyncs climbing into
    the hundreds while the part stopped delivering packets entirely -- EPKTCNT
    reading 0 forever with the poll loop still running.
    Replace it with the only sequence known to bring the part back from an unknown
    state, which eth_top already implements: pulse the hardware reset line, clear
    ECON2.PWRSV, system reset, confirm ESTAT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
    [eth_top.v, net_stack.v, tb_m3.v]
2026-08-28 Let the board identify itself, and pick build flags from it
    The two boards are indistinguishable to JTAG -- openFPGALoader reports the same
    EP4CE6 IDCODE for either -- so nothing in the programming path can tell them
    apart, and flashing Host A's bitstream onto Host B silently gives it Host A's
    IP and MAC. That mistake was made more than once during bring-up, and testing a
    node that was quietly running an older bitstream cost several wrong
    conclusions.
    The console cable can answer what the JTAG cable cannot. uart_console now emits
    ID HOST=A BLD=0003
    once at power-up and every ~2.7 s after. Listening for it beats the
    alternatives: reading the power-on banner needs a reset, which throws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
    [eth_top.v, tb_uart.v, uart_console.v]
2026-08-28 Record both nodes stable on build 0003
    Dual 15-minute soak with both boards on the same build: 612 and 457 frames,
    zero chain corruptions, FSM alive throughout, both still answering ARP
    afterwards. The switch learns both MACs on their documented ports with every
    error counter at zero.
    Also records the -Auto behaviour verified on hardware now that both boards
    identify themselves: with two consoles attached the scan lists both and refuses
    to guess, and -Port selects one and confirms the build after programming.
    M3 is stable on both nodes, which unblocks board-to-board M4.
2026-08-29 Find why board-to-board messaging fails: the MAC address was never written
    Host A transmits correctly -- the switch counts +1 unicast and +67 octets,
    exactly a 21-byte UDP payload plus headers and CRC -- and forwards the frame to
    Host B's port. Host B receives nothing, while still answering ARP and accepting
    UDP broadcasts. Only unicast addressed to it vanishes.
    Add a message counter (M= on the console) so "a frame went past" and "a message
    was accepted and stored" can be told apart; until now only the OLED showed the
    difference, which made board-to-board messaging impossible to test without eyes
    on the panel. With it the split is immediate: a PC unicast to .61 leaves M at
    0, the same paylo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
    [eth_top.v, net_stack.v, tb_m2.v, tb_m4.v, tb_uart.v, uart_console.v]
2026-08-29 Hold CS for 210ns on MAC/MII access -- the MAC address now reaches the chip
    Board-to-board messaging failed because Host B dropped every unicast frame
    addressed to it while still answering broadcast ARP. ERXFCON read back as 0xA1
    (UCEN set), the PC's ARP table and the switch both agreed the frame carried
    Host B's MAC, so by elimination MAADR could not hold that MAC.
    Reading MAADR back needed the read protocol fixed first: MAC and MII registers
    shift out a dummy byte before the data, so those reads are three bytes where
    ETH and common registers take two. That is why this project's earlier
    MAC-register readbacks returned nonsense and were abandoned as a silicon quirk.
    With a correct read the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
    [eth_top.v]
2026-08-29 Both nodes on the CS-hold build: bidirectional messaging, clean 15-minute soak
    Host A flashed with the CS-hold fix and now reports MAC=0242CE600001, so both
    nodes finally hold their own MAC address and both accept unicast.
    Messaging works in both directions, and each message increments only the
    receiver's counter -- no cross-talk: A->B took Host B from 3 to 4, B->A took
    Host A from 0 to 1, and a further A->B took Host B to 5.
    Dual 15-minute soak with both nodes on build 000A: 1,009 and 1,316 frames, 408
    and 651 ARP requests parsed, zero chain corruptions on either, longest stall 5 s
    and 4 s, both still answering ARP afterwards. A message sent after the soak
    still arrived.
    This soak matter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
2026-08-29 Add KEY3 as a deliberate trigger for the re-init recovery path
    The full re-initialisation recovery has never run on real hardware. X has
    stayed at 0 through every soak since the CS-hold and SPI-phase faults were
    fixed, so the corruption it exists to recover from no longer happens. That is
    the outcome we wanted, but it leaves a recovery path proven only in
    simulation -- and a recovery path that has only ever executed in a testbench is
    not one to rely on.
    KEY3 now forces a re-init on demand. net_stack latches the request wherever it
    arrives, exactly as it does for a queued message, and acts on it from the idle
    poll so it can never interrupt a frame mid-flight. Forced re-inits count as X=
    on t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
    [eth_top.v, net_stack.v, tb_m3.v, tb_m4.v]
2026-08-29 Recover from a silent receiver, not just a corrupt chain
    KEY3 proved the re-init path works on real silicon: Host A performed 542
    re-initialisations and kept serving ARP throughout, with frames and ARP
    counters advancing the whole time.
    It also exposed a failure the recovery was blind to. Host B wedged with frames,
    ARP and the resync count all frozen while the poll counter kept advancing --
    a perfectly healthy state machine polling a part that had stopped handing
    frames over. The chain-corruption check only runs from cleanup, and cleanup is
    reached by processing a frame, so when EPKTCNT reads 0 for ever nothing ever
    asks for recovery. The node cannot detect its own silence.
    Make silence it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
    [eth_top.v, net_stack.v, tb_m3.v]
2026-08-29 Prove the stall watchdog on hardware, and add the test that does it
    Creating 30 s of silence on a live LAN is awkward, since broadcast traffic
    arrives every second or so. pc/blackout-test.ps1 shuts the node's switch port
    over SSH instead, so nothing has to be unplugged, and restores it in a finally
    block so an interrupted run cannot leave the port down.
    Result on Host A:
    baseline F=113 A=80 X=9
    port shut F=113 A=80 X=11 frames frozen, X rose by 2
    port restored F=119 A=85 X=12 frames resumed
    Two re-initialisations across a 60-second blackout matches the ~30 s period,
    and the node resumed receiving as soon as the link returned.
    All three routes into the rec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
2026-08-29 Add a single-process dual-node soak
    Two background loggers kept producing empty logs -- the port ends up held by a
    leftover process, or the child exits before it samples -- and a silent logger
    is worse than none, because it looks exactly like a wedged node. More than one
    wrong conclusion this session came from reading a stale or empty log as if it
    were current.
    This holds both ports in one foreground process instead, and reports frames,
    ARP, replies, re-inits and the longest gap with no new frame for each node.
    The parser refuses a partially-received line rather than trusting half of it.
2026-08-29 Record the MAC readback as an SPI wiring diagnostic
    After Host B's jumpers were disturbed and reconnected it ran, but performed 633
    re-initialisations in eight minutes against Host A's zero on the same bitstream.
    The console's MAC= field identified the cause in one glance: Host B read back
    020000000000, then 000000000000, differing on every re-init, while Host A read
    a stable and correct 0242CE600001.
    MAADR is written once at init and re-read on every re-init, so it is a free,
    continuously repeated integrity check on the SPI read path. A value that is
    wrong AND changes between reads is not a firmware bug when the same image is
    correct on the other node -- it is a marginal connection. Reseat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
2026-08-30 Consolidate the plan and set out the M5 phase
    docs/plan.md had grown into a chronological debugging log -- eleven appended
    sections under "Stability", written as each fault was found. That is a fine way
    to take notes and a poor way to hand someone the state of the project. Replace
    it with a status section that says where things actually are, a five-row
    summary of the faults pointing at enc28j60.md for the detail rather than
    repeating it, and an M5 plan. 423 lines down to 287, with nothing lost that is
    not written up more fully elsewhere.
    Records honestly that Host A is down at the time of writing: MAC reads back as
    all zeros and it is unreachable, while its switch port still shows connected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
2026-08-30 Answer ICMP echo requests, so ping succeeds rather than timing out
    M3's exit criterion was ping moving from "unreachable" to "timed out" -- ARP
    resolving with nothing answering the echo. This makes the node answer.
    The reply is the request with the addresses swapped, the type set to 0 and both
    checksums redone. Everything from the identifier onward goes back exactly as it
    arrived, because the sender compares it. The IPv4 header checksum is computed
    rather than copied, since the request's covers the request's addresses. The ICMP
    checksum uses the RFC 1624 incremental update -- the only field that changes is
    the type, so re-summing the payload would buy nothing.
    Echoes are answered only when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
    [eth_top.v, net_stack.v, tb_m4.v]
2026-08-30 ICMP echo confirmed on hardware: ping returns replies
    30 of 30, zero loss, TTL 64, sub-millisecond. Host A, still on the previous
    build, timed out on the same LAN during the same test -- about as clean a
    control as this project has managed, since it isolates the firmware from
    everything environmental.
    The payload bound behaves exactly as designed. ping and ping -l 32 are
    answered; ping -l 40 and larger are walked and ignored, because a 40-byte
    payload makes a 48-byte ICMP message and the echo buffer holds 40. A truncated
    reply would be rejected by the sender, so declining to answer is the honest
    response rather than a limitation worth hiding.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
2026-08-30 Send button state to the peer, shown on its OLED
    Pressing a button on one node now puts its key state on the other node's
    display, in the same notation as the local KEYS console line: "A KEYS 0.2." is
    node A with keys 0 and 2 held. Using one notation for both means the reader
    does not have to translate between "the buttons under my hand" and "the buttons
    on the other board".
    Entirely sender-side. The receiver already renders any incoming message on OLED
    line 3, so reusing the proven M4 message path rather than adding a second
    protocol meant there was nothing to change at the far end.
    The payload is generated from a case rather than stored in a buffer: the string
    is almost entirely constant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
2026-08-30 Count button updates on the console, to tell three failures apart
    A button press on one node did not appear on the other's display, and "it did
    not appear" has at least three causes with no way to distinguish them: the
    button never reached the design, the send never fired, or the frame never
    arrived.
    Add B= to the NET line, counting button updates actually queued for
    transmission. Together with the receiver's M= that splits the question cleanly:
    B stays at zero and the trigger never fired; B counts but M does not and the
    frame is being lost on the wire; both count and the fault is in the display.
    Bisecting first established the transmit path itself is sound -- a line typed
    on Host B's cons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
    [eth_top.v, uart_console.v]
2026-08-30 Record button-state messaging working on hardware
    Five presses of KEY0 on Host A produced ten sends, ten 67-byte frames counted
    by the switch, and ten messages accepted by Host B -- the sender's counter, the
    switch and the receiver all agreeing. Ten for five because press and release
    are both real state changes and the display should follow both.
    Both nodes now run build 000F, so the feature works in either direction, and
    both reply to ping. Typed messages were re-verified both ways at the same time.
    The B= counter is the reason this was diagnosable. "The peer's display did not
    change" has three causes -- the button never reached the design, the send never
    fired, or the frame never arrived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
2026-08-30 Button messaging confirmed in both directions
    Five presses of KEY0 on Host B gave B=10 at the sender and took Host A's M from
    1 to 11 -- ten sent, ten accepted, matching the A->B direction exactly. Both
    nodes run build 000F, so the feature is symmetric rather than one-way.
    That closes both of the goals set for this phase: each node answers ping, and a
    button pressed on either node shows its key state on the other node's display.
